parkourlrc/pcb-pivikd--AMP-MA-a9fabbb7ca/README.md

<p align="center">
   
   
</p><p align="center">
   
   
</p>

# Project Status

   **AMP-MA is currently in the early development phase and is considered unstable. The first stable release is scheduled for Q4 2026**
   
   **The project is currently in the pre-alpha stage – creating the first prototype**

# AMP-MA (AMP Modus Aequale)

AMP-MA (standing for Modus Aequale, signifying a rhythmic, ideal tone and modular structure) is an open-source, transistor-based guitar combo amplifier project. It is designed to bridge the gap between solid-state reliability and the organic, harmonic richness of vacuum tube sound.

The project focuses on a modular architecture, originally developed as a high-fidelity upgrade for the **Epiphone 15C** PCB. By utilizing independent blocks, AMP-MA allows for seamless customization and easier adaptation to various amp enclosures.

This project is designed and maintained by: [Danylo Pyvovarov](https://github.com/pivikd).

   1. [Key Features](#key-features)
   1. [Signal Chain](#signal-chain)
   1. [Integrated Tone Stacks](#integrated-tone-stacks)
<!-- 1. [Integrated Effects Modules](#integrated-effects-modules) -->
## Key Features
   - **Tube-like Architecture**: Uses **Mu-amp** based cascades with **2SK30A** transistors to achieve a warm, organic sound and harmonic saturation that mimics vacuum tube behavior.

   - **Dual Input Support**: Designed to handle two guitars simultaneously.

   - **Legendary Tone Stacks**: Features a 3-band EQ based on the classic tone stacks([Integrated Tone Stacks](#integrated-tone-stacks)).

   - **Integrated Compression**: Built-in compressor block based on the vintage **Ibanez CP835** circuitry.

   <!-- - **Modular Design**: Optimized for easy integration into different amp cabinets or for swapping internal effect modules. -->

## Signal Chain
   1. Input buffer
   1. Preamp ([Mu-AMP](https://www.muzique.com/amz/mini.htm))
   1. Compressor ([Ibanez CP835](https://www.scribd.com/document/976348354/Ibanez-CP835-Schematic))
   1. Tone Stack
   1. Recovery Stage
   1. Power Amp ([LM1875](https://www.ti.com/lit/ds/symlink/lm1875.pdf))

<!-- ## Integrated Effects Modules
| Effect | based on |  Status  |
|---|---|---|
| Compressor | Ibanez CP835 |  done |
<!-- | Over Drive        | Boss OD3     | planned  |
| Chorus            | Boss Ch1     | planned  | --> 

## Integrated Tone Stacks
   - Fender Treble-Middle-Bass
   - Marshall ([JCM900 2100 SL-X](https://stompboxelectronics.com/2023/12/16/the-marshall-tone-stacks/))
   - Dumble Rock

      Own:
   - TS0 (based on Marshall JCM900 2100 SL-x)
   - TS1 (based on Dumble Rock)
