parkourlrc/pcb-pivikd--AMP-MA-a9fabbb7ca/PrLib/3D/Jack.step

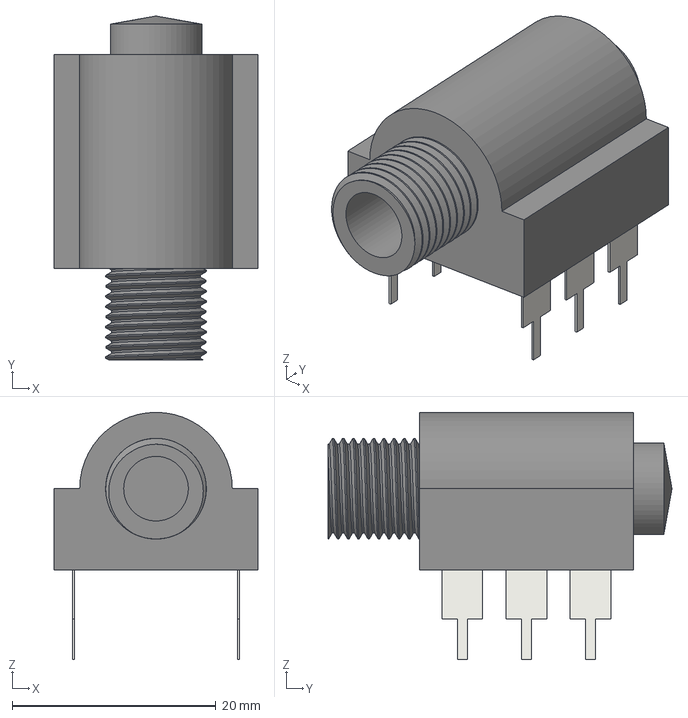
[picture p1: CAD file, 2026-11-06]
PrLib/3D/Jack.step
20.0 x 33.8 x 24.3 mm
