parkourlrc/pcb-pivikd--AMP-MA-a9fabbb7ca/AMP-MA.kicad_pcb

## KiCad design AMP-MA.kicad_pcb (2026-11-06)

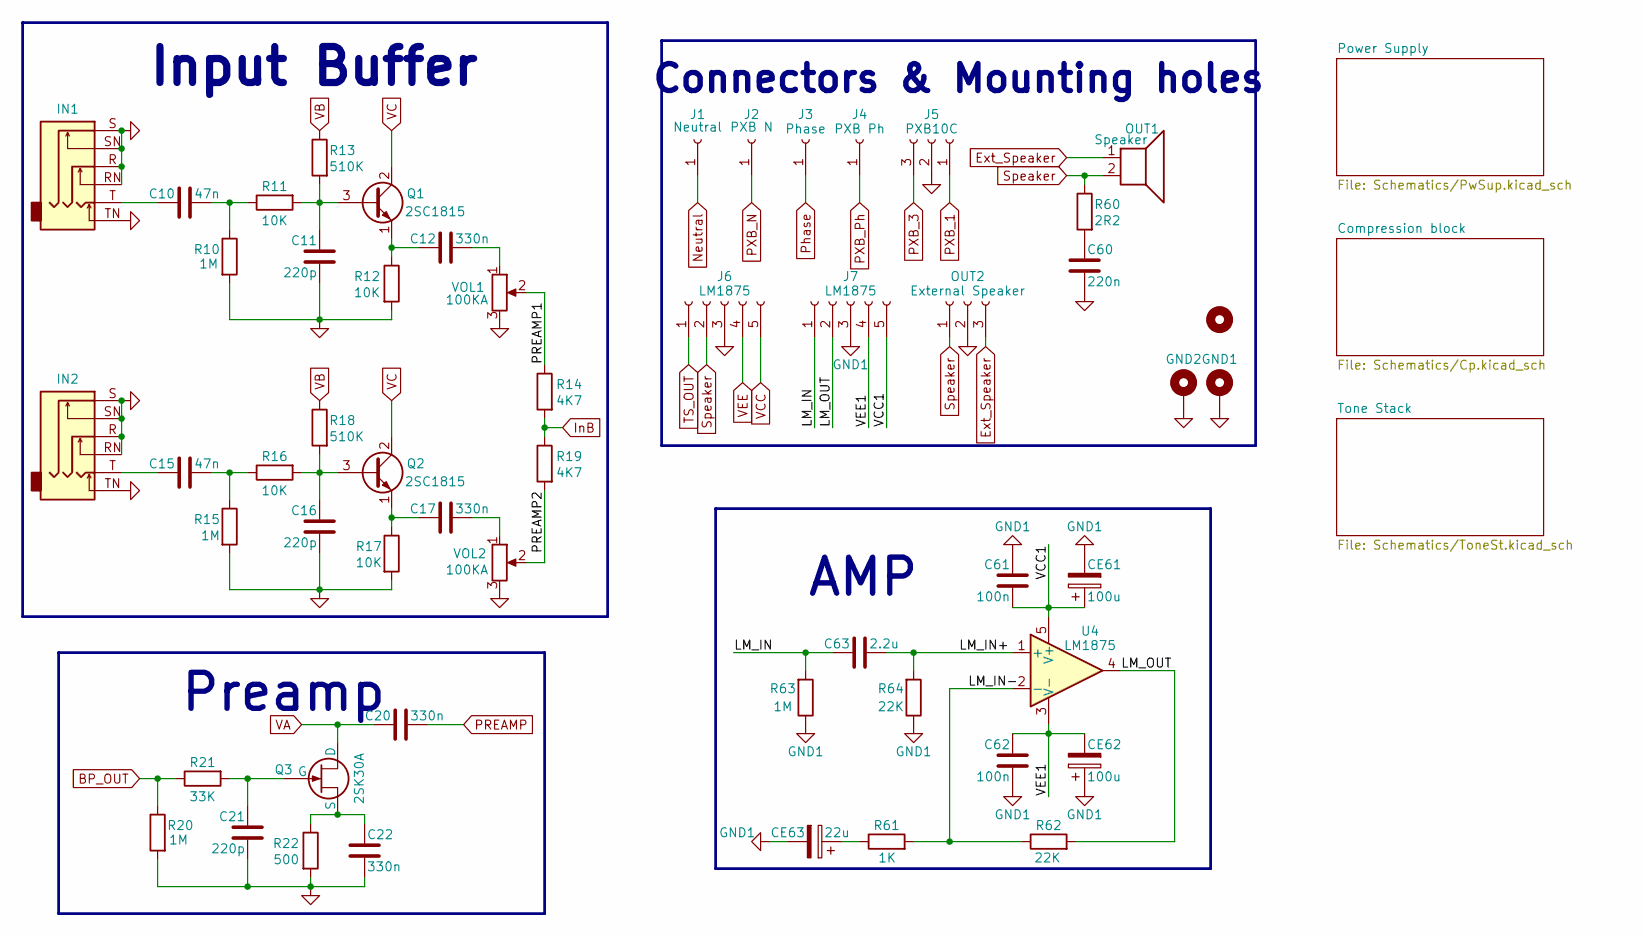
[picture p2: schematic AMP-MA.kicad_sch, AMP-MA Main part]

Parts:
C10, C15: 47n; C_disc_D7_W2.5_P5
C11, C16, C21: 220p; C_disc_D7_W2.5_P5
C12, C17, C20, C22: 330n; C_disc_D7_W2.5_P5
C60: 220n; C_disc_D7_W2.5_P5
C61, C62: 100n; C_disc_D7_W2.5_P5
C63: 2.2u; C_disc_D7_W2.5_P5
CE61, CE62: 100u; CP_Radial_D6.3mm_P2.50mm
CE63: 22u; CP_Radial_D5.0mm_P2.50mm
GND1, GND2: MountingHole_Pad; MountingHole_2.2mm_M2_DIN965_Pad
H2: MountingHole; MountingHole_2.2mm_M2
IN1, IN2: Jack_3_6pin
J1: Neutral; connector
J2: PXB N; connector
J3: Phase
J4: PXB Ph
J5: PXB10C; JST_XH_B3B-XH-A_1x03_P2.50mm_Vertical
J6, J7: LM1875; JST_XH_B5B-XH-A_1x05_P2.50mm_Vertical
OUT1: Speaker; PinSocket_1x02_P2.54mm_Vertical
OUT2: External Speaker; JST_XH_B3B-XH-A_1x03_P2.50mm_Vertical
Q1, Q2: 2SC1815; TO-92_Inline_Wide
Q3: 2SK30A; TO-92_Inline_Wide
R10, R15, R20, R63: 1M; R_Axial_DIN0207_L6.3mm_D2.5mm_P10.16mm_Horizontal
R11, R12, R16, R17: 10K; R_Axial_DIN0207_L6.3mm_D2.5mm_P10.16mm_Horizontal
R13, R18: 510K; R_Axial_DIN0207_L6.3mm_D2.5mm_P10.16mm_Horizontal
R14, R19: 4K7; R_Axial_DIN0207_L6.3mm_D2.5mm_P10.16mm_Horizontal
R21: 33K; R_Axial_DIN0207_L6.3mm_D2.5mm_P10.16mm_Horizontal
R22: 500; R_Axial_DIN0207_L6.3mm_D2.5mm_P10.16mm_Horizontal
R60: 2R2; R_Axial_DIN0207_L6.3mm_D2.5mm_P10.16mm_Horizontal
R61: 1K; R_Axial_DIN0207_L6.3mm_D2.5mm_P10.16mm_Horizontal
R62, R64: 22K; R_Axial_DIN0207_L6.3mm_D2.5mm_P10.16mm_Horizontal
U4: LM1875; TO-220-5_P3.4x3.7mm_StaggerOdd_Lead3.8mm_Vertical
VOL1, VOL2: 100KA; potentiometer

Connections:
/LM_IN: C63.1, J7.1, R63.2
/LM_IN+: C63.2, R64.2, U4.1 (+)
/LM_IN-: R61.2, R62.1, U4.2 (-)
/LM_OUT: J7.2, R62.2, U4.4
/PREAMP1: R14.1, VOL1.2
/PREAMP2: R19.2, VOL2.2
/VCC1: C61.2, CE61.1, J7.5, U4.5 (V+)
/VEE1: C62.1, CE62.2, J7.4, U4.3 (V-)
BP_OUT: R20.1, R21.1; also elsewhere on the board
Ext_Speaker: OUT1.1, OUT2.3
GND: C11.1, C16.1, C21.1, C22.1, C60.2, GND1.1 (1_1), GND2.1 (1_1), IN1.R, IN1.RN, IN1.S, IN1.SN, IN1.TN, IN2.R, IN2.RN, IN2.S, IN2.SN, IN2.TN, J5.2, J6.3, OUT2.2, R10.2, R12.2, R15.2, R17.2, R20.2, R22.2, VOL1.3, VOL2.3; also elsewhere on the board
GND1: C61.1, C62.2, CE61.2, CE62.1, CE63.2, J7.3, R63.1, R64.1
InB: R14.2, R19.1; also elsewhere on the board
unnamed: C10.1, IN1.T
unnamed: C10.2, R10.1, R11.1
unnamed: C12.2, VOL1.1
unnamed: C15.1, IN2.T
unnamed: C15.2, R15.1, R16.1
unnamed: C17.2, VOL2.1
unnamed: C60.1, R60.2
unnamed: CE63.1, R61.1
unnamed: C11.2, Q1.3 (B), R11.2, R13.2
unnamed: C12.1, Q1.1 (E), R12.1
unnamed: C16.2, Q2.3 (B), R16.2, R18.2
unnamed: C17.1, Q2.1 (E), R17.1
unnamed: C21.2, Q3.2 (G), R21.2
unnamed: C22.2, Q3.3 (S), R22.1
Neutral: J1.1 (Pin_1_1); also elsewhere on the board
PREAMP: C20.2; also elsewhere on the board
PXB_1: J5.1; also elsewhere on the board
PXB_3: J5.3; also elsewhere on the board
PXB_N: J2.1 (Pin_1_1); also elsewhere on the board
Speaker: J6.2, OUT1.2, OUT2.1, R60.1
TS_OUT: J6.1; also elsewhere on the board
VA: C20.1, Q3.1 (D); also elsewhere on the board
VB: R13.1, R18.1; also elsewhere on the board
VC: Q1.2 (C), Q2.2 (C); also elsewhere on the board
VCC: J6.5; also elsewhere on the board
VEE: J6.4; also elsewhere on the board

Notes on the sheet:
Preamp
Connectors & Mounting holes
AMP
Input Buffer

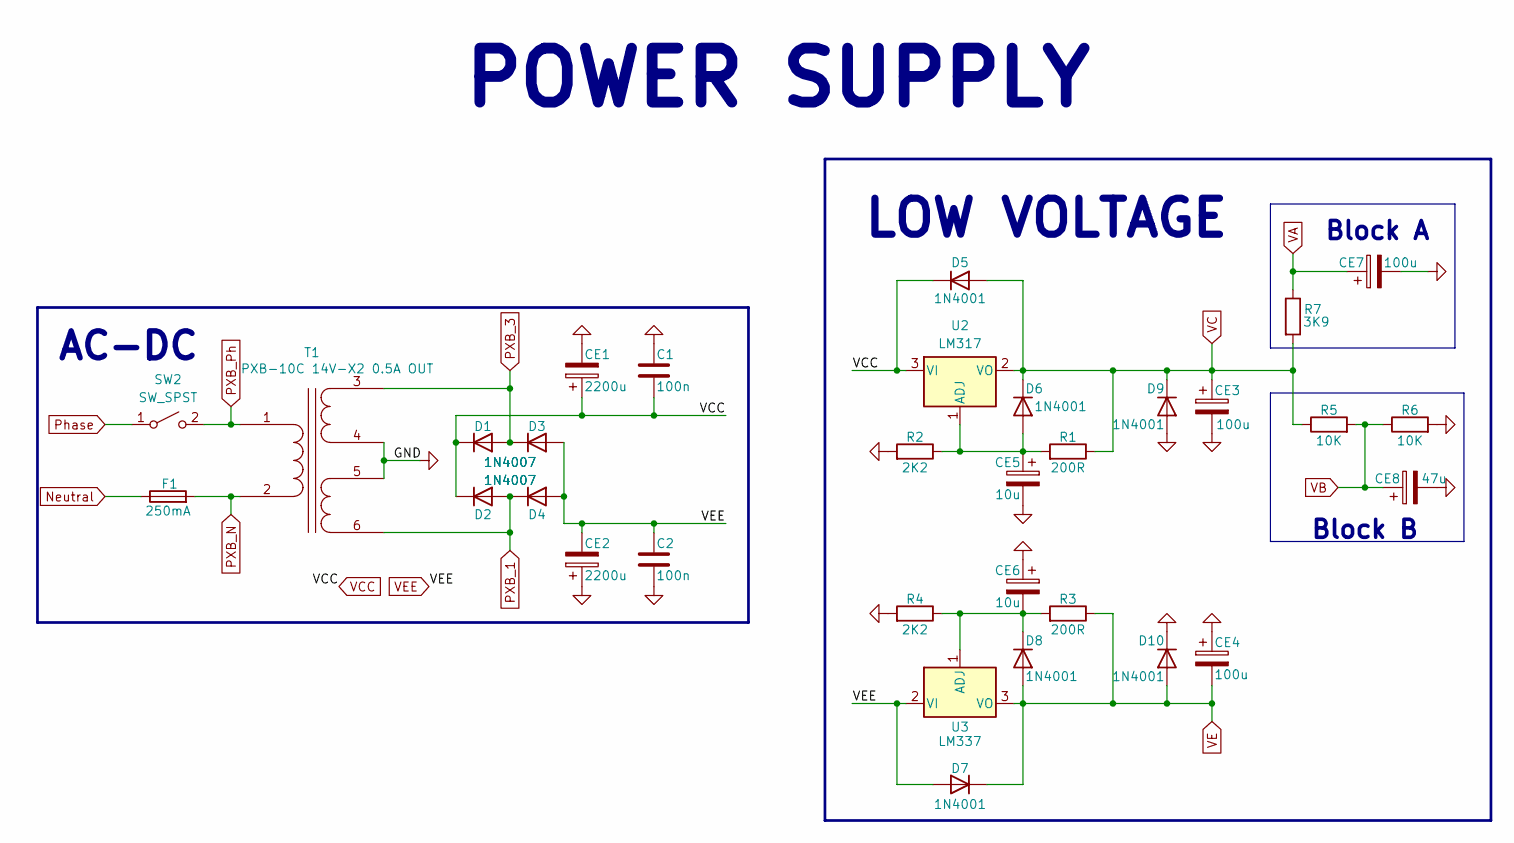
[picture p3: schematic PwSup.kicad_sch, AMP-MA Pwer Supply part]

Parts:
C1, C2: 100n; C_disc_D7_W2.5_P5
CE1, CE2: 2200u; CP_Radial_D16.0mm_P7.50mm
CE3, CE4, CE7: 100u; CP_Radial_D6.3mm_P2.50mm
CE5, CE6: 10u; CP_Radial_D5.0mm_P2.50mm
CE8: 47u; CP_Radial_D5.0mm_P2.50mm
D1, D2, D3, D4: 1N4007; D_DO-41_SOD81_P10.16mm_Horizontal
D5, D6, D7, D8, D9, D10: 1N4001; D_DO-41_SOD81_P10.16mm_Horizontal
F1: 250mA; Fuseholder_Clip-5x20mm_Littelfuse_520_Inline_P20.50x5.80mm_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
R1, R3: 200R; R_Axial_DIN0207_L6.3mm_D2.5mm_P10.16mm_Horizontal
R2, R4: 2K2; R_Axial_DIN0207_L6.3mm_D2.5mm_P10.16mm_Horizontal
R5, R6: 10K; R_Axial_DIN0207_L6.3mm_D2.5mm_P10.16mm_Horizontal
R7: 3K9; R_Axial_DIN0207_L6.3mm_D2.5mm_P10.16mm_Horizontal
SW2: SW_SPST
T1: PXB-10C 14V-X2 0.5A OUT
U2: LM317; TO-220-3_Horizontal_TabDown
U3: LM337; TO-220-3_Horizontal_TabDown

Connections:
GND: C1.2, C2.2, CE1.2, CE2.1, CE3.2, CE4.1, CE5.2, CE6.1, CE7.2, CE8.2, D9.2 (A), D10.1 (K), R2.2, R4.2, R6.2, T1.4 (SB), T1.5 (SC); also elsewhere on the board
unnamed: CE5.1, D6.2 (A), R1.2, R2.1, U2.1 (ADJ)
unnamed: CE6.2, D8.1 (K), R3.2, R4.1, U3.1 (ADJ)
unnamed: SW2.2 (B), T1.1 (AA)
Neutral: F1.1; also elsewhere on the board
PXB_1: D2.2 (A), D4.1 (K), T1.6 (SD); also elsewhere on the board
PXB_3: D1.2 (A), D3.1 (K), T1.3 (SA); also elsewhere on the board
PXB_N: F1.2, T1.2 (AB); also elsewhere on the board
VA: CE7.1, R7.1; also elsewhere on the board
VB: CE8.1, R5.2, R6.1; also elsewhere on the board
VC: CE3.1, D5.2 (A), D6.1 (K), D9.1 (K), R1.1, R5.1, R7.2, U2.2 (VO); also elsewhere on the board
VCC: C1.1, CE1.1, D1.1 (K), D2.1 (K), D5.1 (K), U2.3 (VI); also elsewhere on the board
VE: CE4.2, D7.1 (K), D8.2 (A), D10.2 (A), R3.1, U3.3 (VO); also elsewhere on the board
VEE: C2.1, CE2.2, D3.2 (A), D4.2 (A), D7.2 (A), U3.2 (VI); also elsewhere on the board

Notes on the sheet:
AC-DC
Block A
Block B
LOW VOLTAGE
POWER SUPPLY

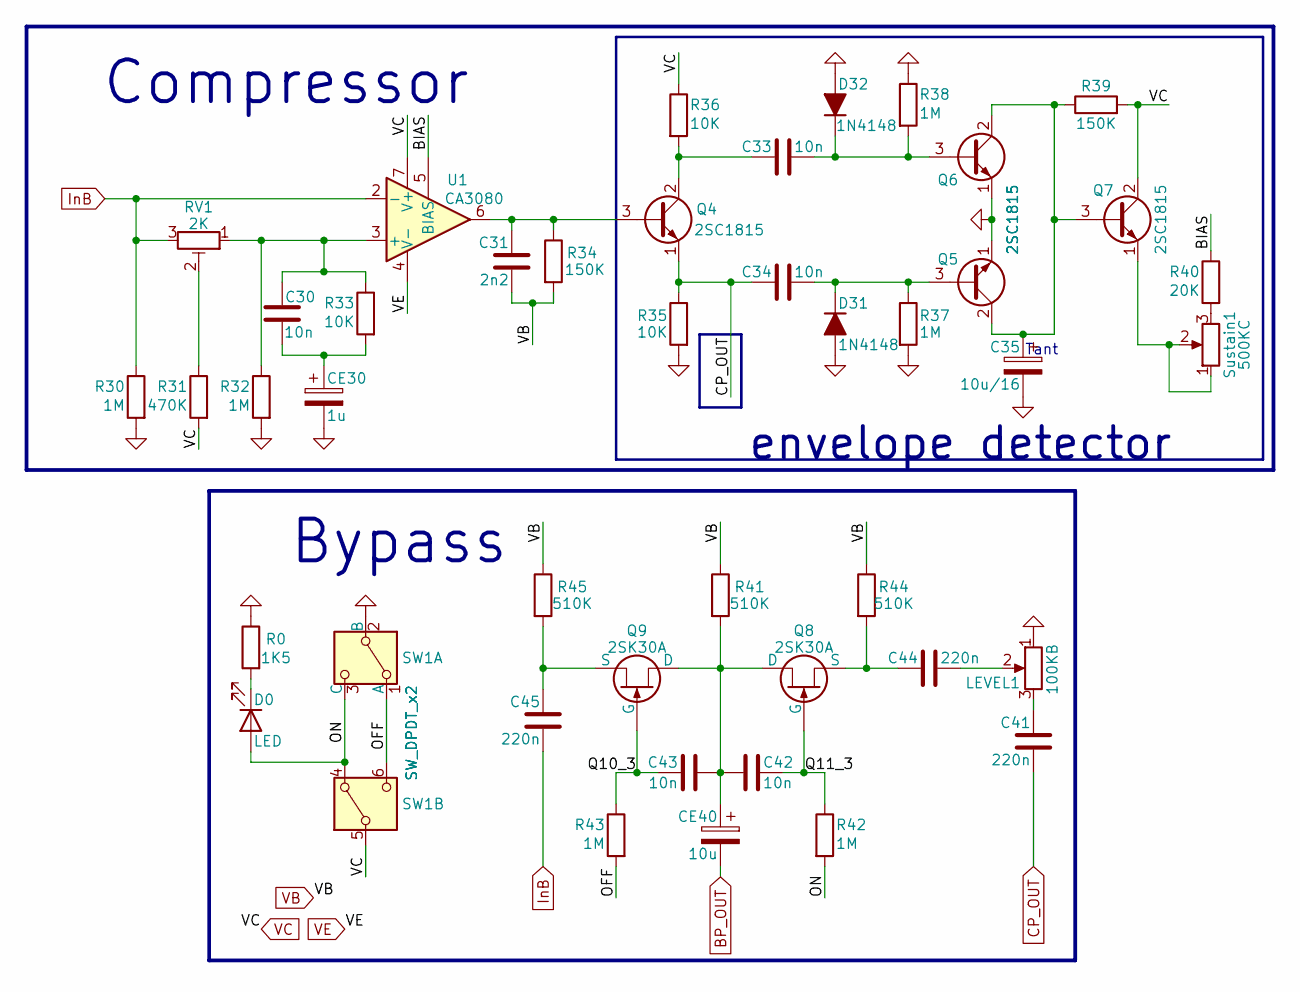
[picture p4: schematic Cp.kicad_sch, AMP-MA Compressor and bypass part]

Parts:
C30: 10n; C_disc_D7_W2.5_P5
C31: 2n2; C_Disc_D4.3_W1.9_P5.00
C33, C34, C42, C43: 10n; C_Disc_D4.3_W1.9_P5.00
C35: 10u/16; CP_Radial_Tantal_D5.5mm_P2.50mm
C41, C44, C45: 220n; C_disc_D7_W2.5_P5
CE30: 1u; CP_Radial_D4.0mm_P2.00mm
CE40: 10u; CP_Radial_D5.0mm_P2.50mm
D0: LED; LED_D3.0mm_Horizontal_O6.35mm_Z6.0mm
D31, D32: 1N4148; D_DO-35_SOD27_P7.62mm_Horizontal
LEVEL1: 100KB; Potentiometer_Bourns_3296W_Vertical
Q4, Q5, Q6, Q7: 2SC1815; TO-92_Inline_Wide
Q8, Q9: 2SK30A; TO-92_Inline_Wide
R0: 1K5; R_Axial_DIN0207_L6.3mm_D2.5mm_P10.16mm_Horizontal
R30, R32, R37, R38, R42, R43: 1M; R_Axial_DIN0207_L6.3mm_D2.5mm_P10.16mm_Horizontal
R31: 470K; R_Axial_DIN0207_L6.3mm_D2.5mm_P10.16mm_Horizontal
R33, R35, R36: 10K; R_Axial_DIN0207_L6.3mm_D2.5mm_P10.16mm_Horizontal
R34, R39: 150K; R_Axial_DIN0207_L6.3mm_D2.5mm_P10.16mm_Horizontal
R40: 20K; R_Axial_DIN0207_L6.3mm_D2.5mm_P10.16mm_Horizontal
R41, R44, R45: 510K; R_Axial_DIN0207_L6.3mm_D2.5mm_P10.16mm_Horizontal
RV1: 2K; Potentiometer_Bourns_3296W_Vertical
SW1: SW_DPDT_x2; SW DPDT
Sustain1: 500KC; potentiometer
U1: CA3080; DIP-8_W7.62mm

Connections:
/Compression block/BIAS: R40.1, U1.5 (BIAS)
/Compression block/OFF: R43.2, SW1.1 (A), SW1.6 (C)
/Compression block/ON: D0.2 (A), R42.2, SW1.3 (C), SW1.4 (A)
/Compression block/Q10_3: C43.2, Q9.2 (G), R43.1
/Compression block/Q11_3: C42.1, Q8.2 (G), R42.1
BP_OUT: CE40.2; also elsewhere on the board
CP_OUT: C34.1, C41.1, Q4.1 (E), R35.1
GND: C35.2, CE30.2, D31.2 (A), D32.2 (A), LEVEL1.1, Q5.1 (E), Q6.1 (E), R0.1, R30.2, R32.2, R35.2, R37.2, R38.1, SW1.2 (B); also elsewhere on the board
InB: C45.1, R30.1, RV1.3, U1.2 (-); also elsewhere on the board
unnamed: C30.2, CE30.1, R33.2
unnamed: C41.2, LEVEL1.3
unnamed: C44.2, LEVEL1.2
unnamed: D0.1 (K), R0.2
unnamed: C34.2, D31.1 (K), Q5.3 (B), R37.1
unnamed: C33.2, D32.1 (K), Q6.3 (B), R38.2
unnamed: C31.1, Q4.3 (B), R34.1, U1.6
unnamed: C33.1, Q4.2 (C), R36.2
unnamed: C35.1, Q5.2 (C), Q6.2 (C), Q7.3 (B), R39.1
unnamed: Q7.1 (E), Sustain1.1, Sustain1.2
unnamed: C42.2, C43.1, CE40.1, Q8.1 (D), Q9.1 (D), R41.2
unnamed: C44.1, Q8.3 (S), R44.2
unnamed: C45.2, Q9.3 (S), R45.2
unnamed: R31.1, RV1.2
unnamed: R40.2, Sustain1.3
unnamed: C30.1, R32.1, R33.1, RV1.1, U1.3 (+)
VB: C31.2, R34.2, R41.1, R44.1, R45.1; also elsewhere on the board
VC: Q7.2 (C), R31.2, R36.1, R39.2, SW1.5 (B), U1.7 (V+); also elsewhere on the board
VE: U1.4 (V-); also elsewhere on the board

Notes on the sheet:
Bypass
envelope detector
Tant
Compressor

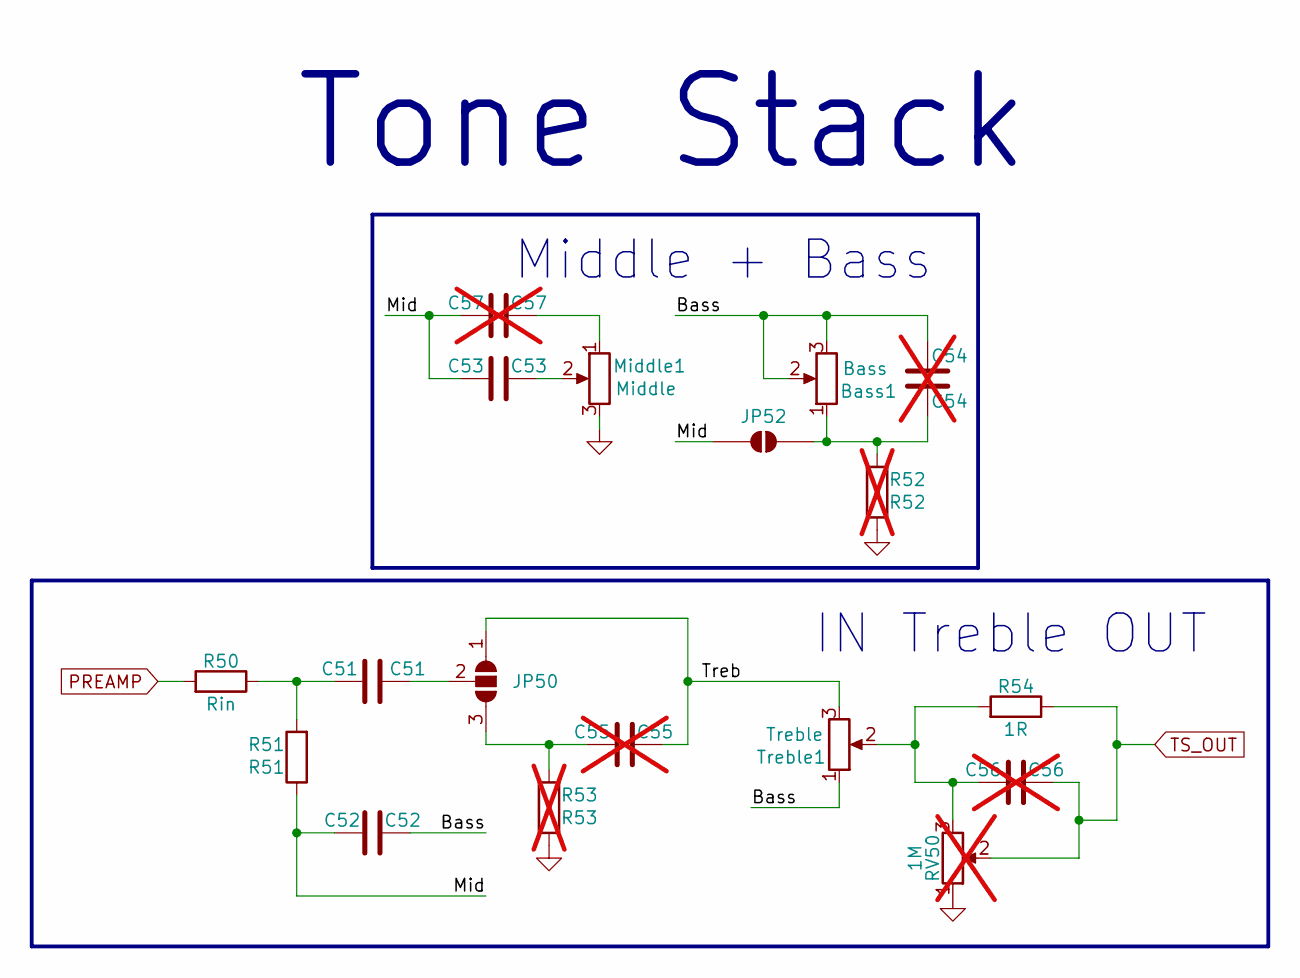
[picture p5: schematic ToneSt.kicad_sch, AMP-MA Tone Stack part]

Parts:
Bass1: Bass; potentiometer
C51: C51; C_disc_D7_W2.5_P5
C52: C52; C_disc_D7_W2.5_P5
C53: C53; C_disc_D7_W2.5_P5
C54: C54; C_disc_D7_W2.5_P5; not fitted
C55: C55; C_disc_D7_W2.5_P5; not fitted
C56: C56; C_disc_D7_W2.5_P5; not fitted
C57: C57; C_disc_D7_W2.5_P5; not fitted
JP50: SolderJumper_3_Open; SolderJumper-3_P2.0mm_Open_TrianglePad1.0x1.5mm_NumberLabels
JP52: SolderJumper_2_Open; SolderJumper-2_P1.3mm_Open_TrianglePad1.0x1.5mm
Middle1: Middle; potentiometer
R50: Rin; R_Axial_DIN0207_L6.3mm_D2.5mm_P10.16mm_Horizontal
R51: R51; R_Axial_DIN0207_L6.3mm_D2.5mm_P10.16mm_Horizontal
R52: R52; R_Axial_DIN0207_L6.3mm_D2.5mm_P10.16mm_Horizontal; not fitted
R53: R53; R_Axial_DIN0207_L6.3mm_D2.5mm_P10.16mm_Horizontal; not fitted
R54: 1R; R_Axial_DIN0207_L6.3mm_D2.5mm_P10.16mm_Horizontal
RV50: 1M; Potentiometer_Bourns_3296W_Vertical; not fitted
Treble1: Treble; potentiometer

Connections:
/Tone Stack/Bass: Bass1.2, Bass1.3, C52.2, C54.2, Treble1.1
/Tone Stack/Mid: C52.1, C53.1, C57.1, JP52.1 (A), R51.1
/Tone Stack/Treb: C55.2, JP50.1 (A), Treble1.3
GND: Middle1.3, R52.1, R53.1, RV50.1; also elsewhere on the board
unnamed: C51.1, R50.1, R51.2
unnamed: C53.2, Middle1.2
unnamed: C56.1, R54.2, RV50.3, Treble1.2
unnamed: C57.2, Middle1.1
unnamed: C55.1, JP50.3 (B), R53.2
unnamed: C51.2, JP50.2 (C)
unnamed: Bass1.1, C54.1, JP52.2 (B), R52.2
PREAMP: R50.2; also elsewhere on the board
TS_OUT: C56.2, R54.1, RV50.2; also elsewhere on the board

Notes on the sheet:
Tone Stack
Middle + Bass
IN Treble OUT

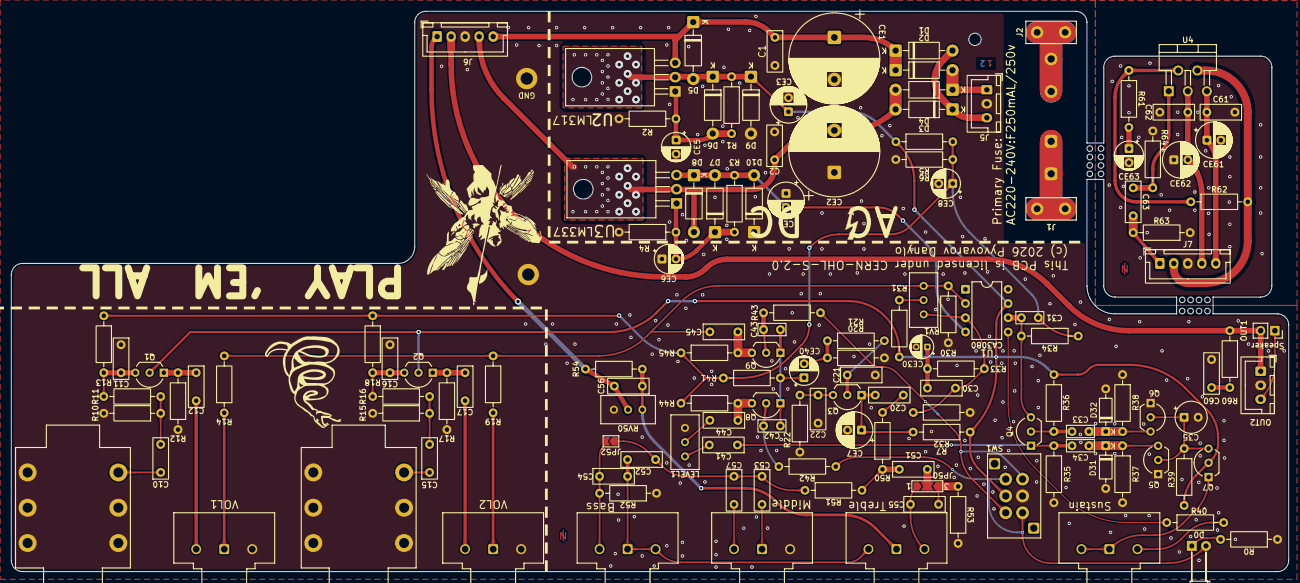
[picture p6: board AMP-MA.kicad_pcb from above]

Board: 2 copper layers, 228.0 x 100.0 mm, 143 parts (1 on the bottom side), 74 nets.
