parkourlrc/pcb-pivikd--AMP-MA-a9fabbb7ca/(commit log)

2026-10-25 Schem. & PCB upd
    [AMP-MA.kicad_pcb, ToneSt.kicad_sch]
2026-10-28 Big upd
    [AMP-MA.kicad_pcb, AMP-MA.kicad_sch, Cp.kicad_sch, PwSup.kicad_sch, ToneSt.kicad_sch]
2026-11-06 Big Update
    [AMP-MA.kicad_pcb, AMP-MA.kicad_sch, Cp.kicad_sch, Jack.step, PwSup.kicad_sch, ToneSt.kicad_sch]
