parkourlrc/pcb-pivikd--AMP-MA-a9fabbb7ca/(notices)

Notices in the files:
Schematics/Cp.kicad_sch:
Copyright (c) 2026 Pyvovarov Dannylo
License: CERN-OHL-S-2.0
README.md:
License: GPL-3.0
AMP-MA.kicad_pcb:
This PCB is licensed under CERN-OHL-S-2.0
(c) 2026 Pyvovarov Danylo
